dill-lk/One-Handed-Keyboard/Model/readme.md

## Heat-Set Insert and Fastener Installation Guide

#### Large Keyboard

> Left-hand large keyboard shown as the example

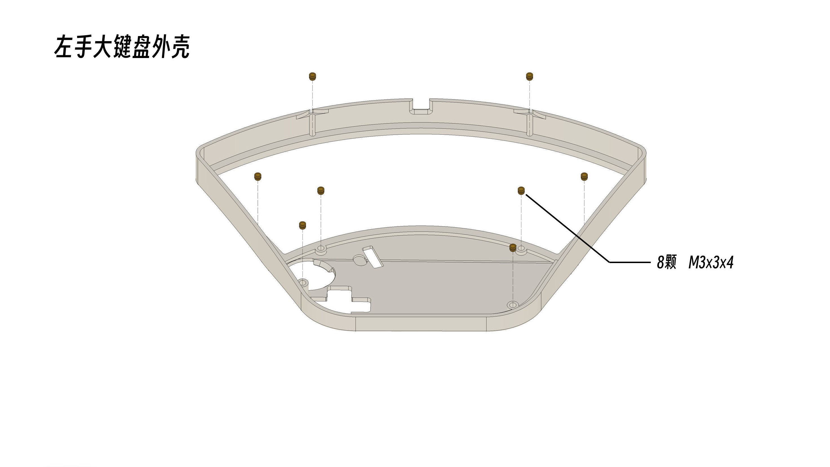
[picture p5: Docs/Image/左手大键盘外壳铜螺母安装示意图.jpg]
Large Keyboard Enclosure Heat-Set Insert Guide


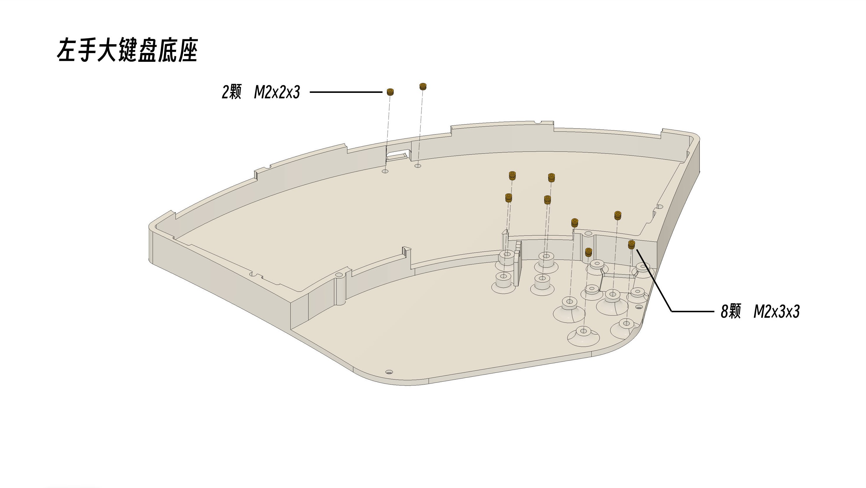
[picture p6: Docs/Image/左手大键盘底座铜螺母安装示意图.jpg]
Large Keyboard Base Heat-Set Insert Guide


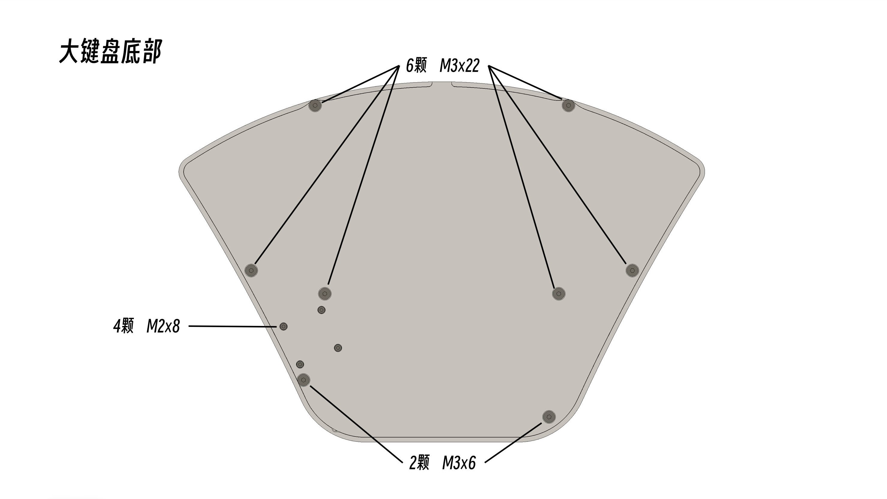
[picture p7: Docs/Image/左手大键盘底部螺丝安装示意图.jpg]
Large Keyboard Bottom Screw Installation Guide


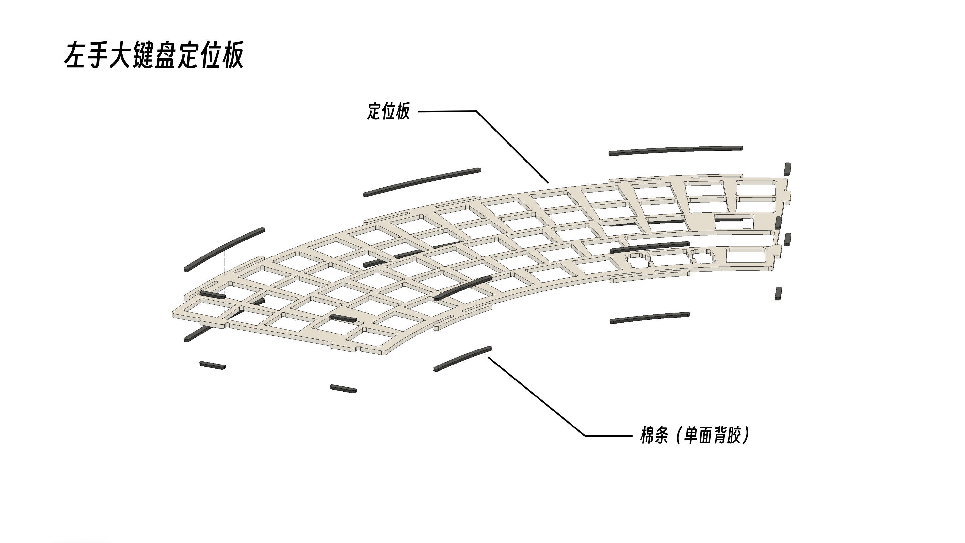
[picture p8: Docs/Image/左手大键盘棉条安装示意图.jpg]
Large Keyboard Foam Strip Installation Guide


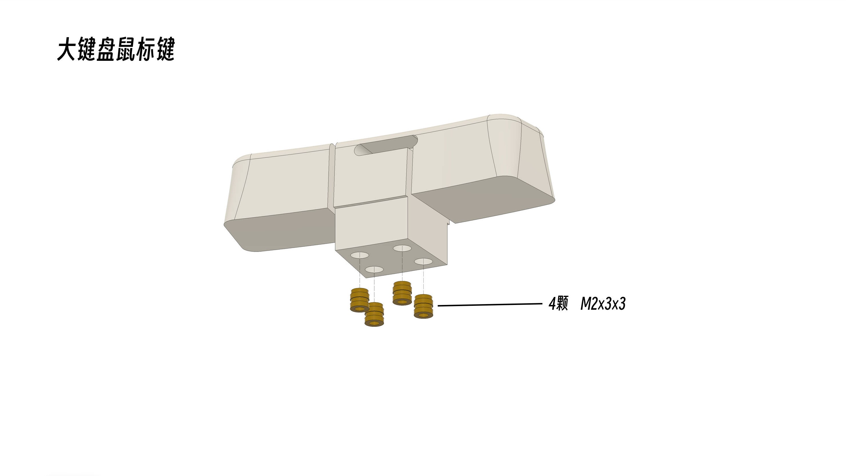
[picture p9: Docs/Image/大键盘鼠标键铜螺母安装示意图.jpg]
Large Keyboard Mouse Button Insert Guide


#### Small Keyboard

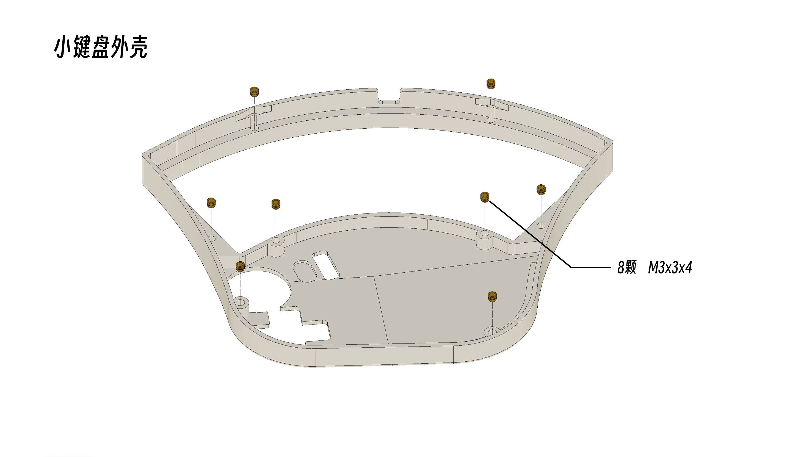
[picture p10: Docs/Image/左手小键盘外壳铜螺母安装示意图.jpg]
Small Keyboard Enclosure Heat-Set Insert Guide


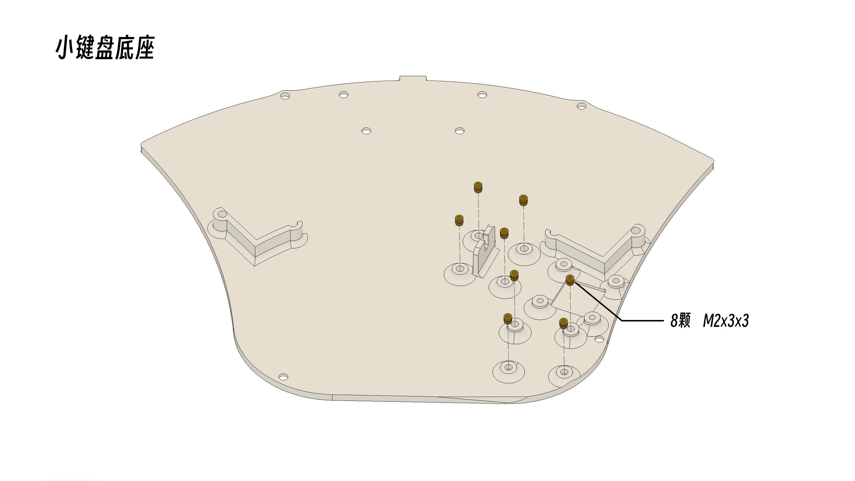
[picture p11: Docs/Image/左手小键盘底座铜螺母安装示意图.jpg]
Small Keyboard Base Heat-Set Insert Guide


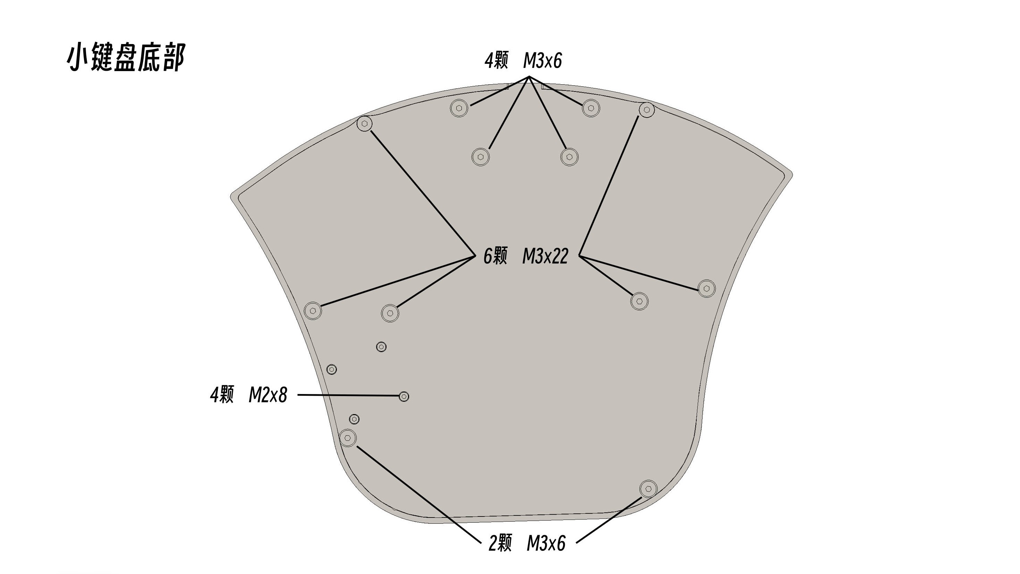
[picture p12: Docs/Image/左手小键盘底部螺丝安装示意图.jpg]
Small Keyboard Bottom Screw Installation Guide


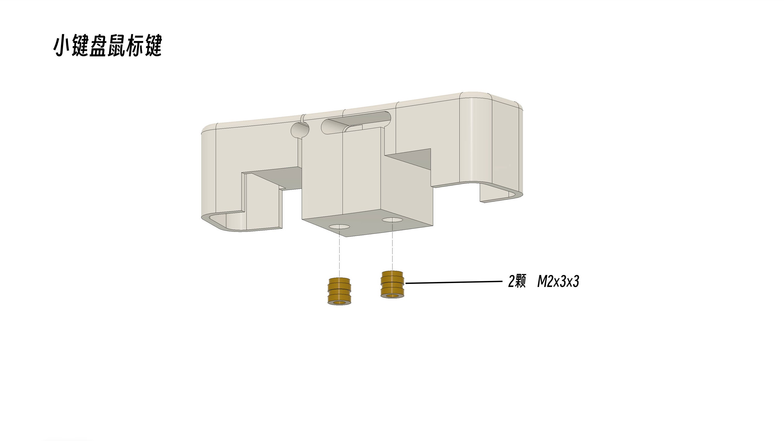
[picture p13: Docs/Image/小键盘鼠标键铜螺母安装示意图.jpg]
Small Keyboard Mouse Button Insert Guide


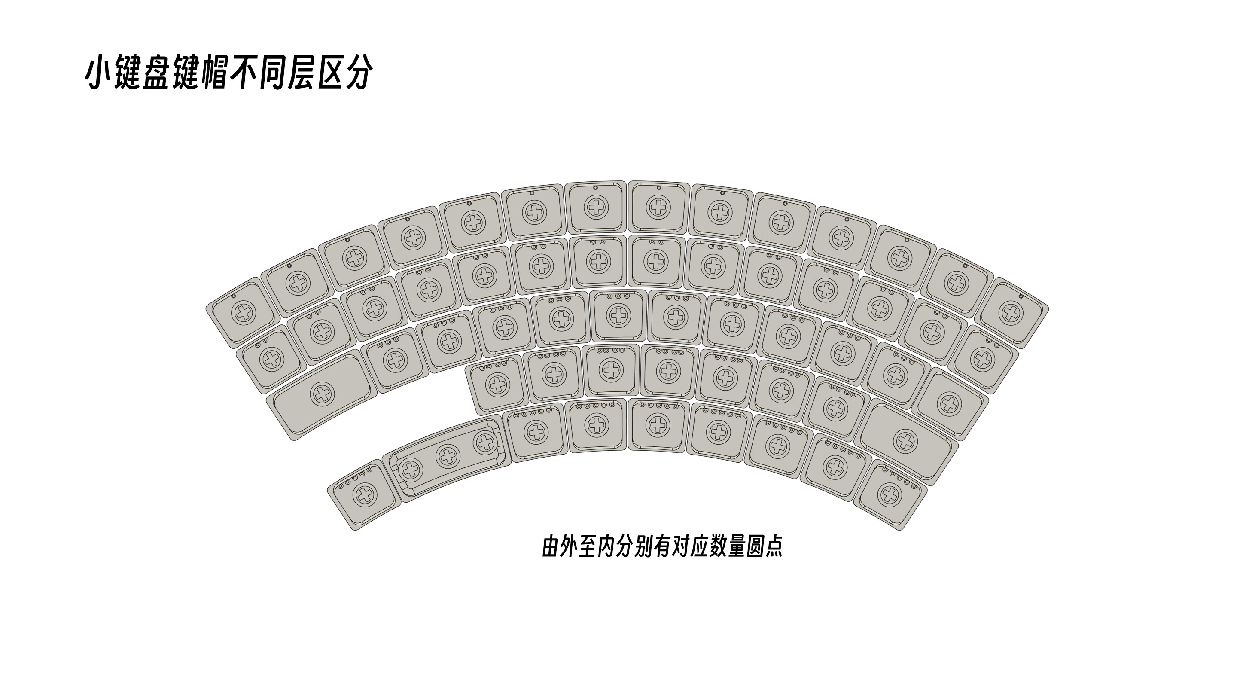
[picture p14: Docs/Image/小键盘键帽不同层区分.jpg]
Small Keyboard Keycap Layer Guide


> Keycap layer distinction is the same for both the small and large keyboards.

#### Other

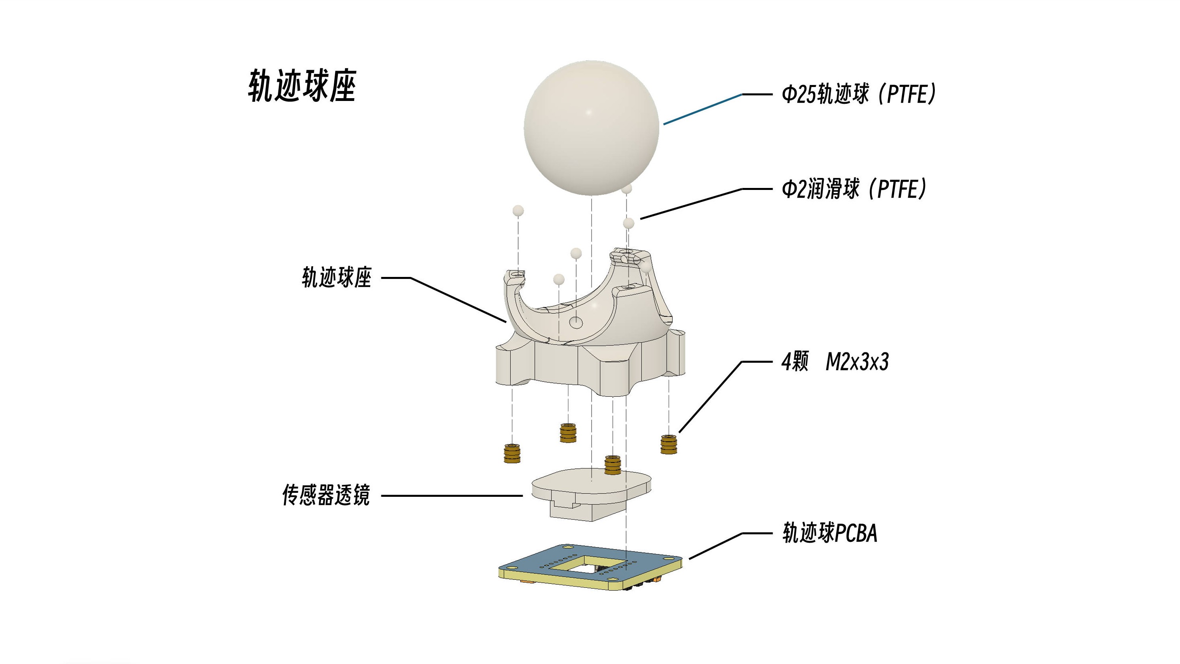
[picture p15: Docs/Image/轨迹球安装示意图.jpg]
Trackball Installation Guide
