dill-lk/One-Handed-Keyboard/Firmware/One-Handed_Keyboard_ML/readme.md

# One-Handed_Keyboard_ML

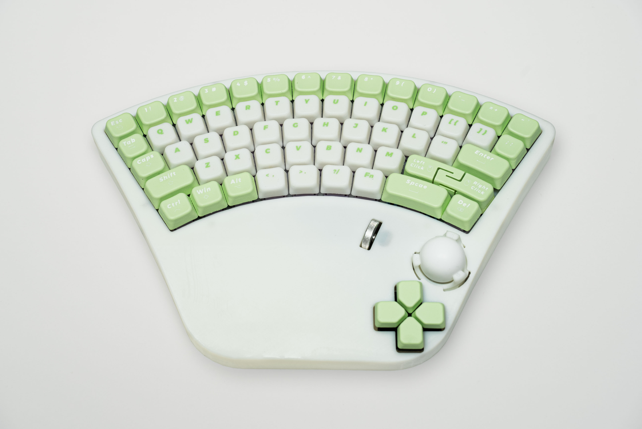
[picture p16: Docs/Image/左手大键盘正面.jpg]
Left Large Keyboard Front


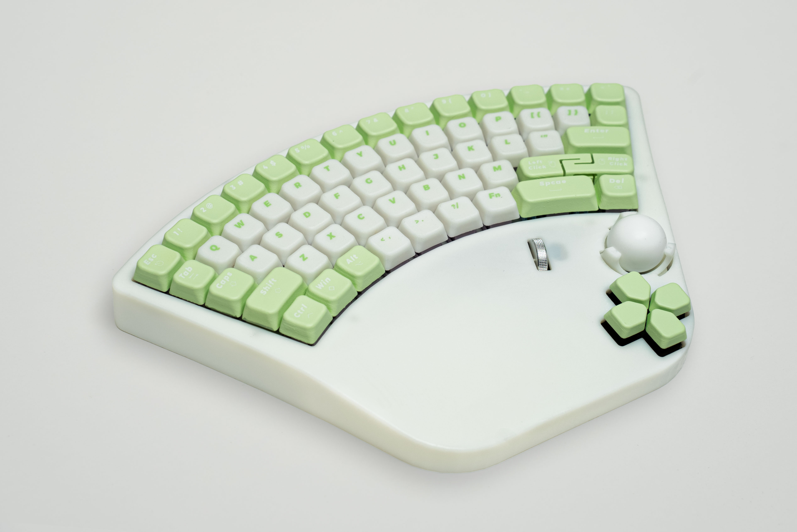
[picture p17: Docs/Image/左手大键盘左侧.jpg]
Left Large Keyboard Side


---

Powered by [QMK](https://docs.qmk.fm/)
