dill-lk/One-Handed-Keyboard/Firmware/One-Handed_Keyboard_MR/readme.md

# One-Handed_Keyboard_MR

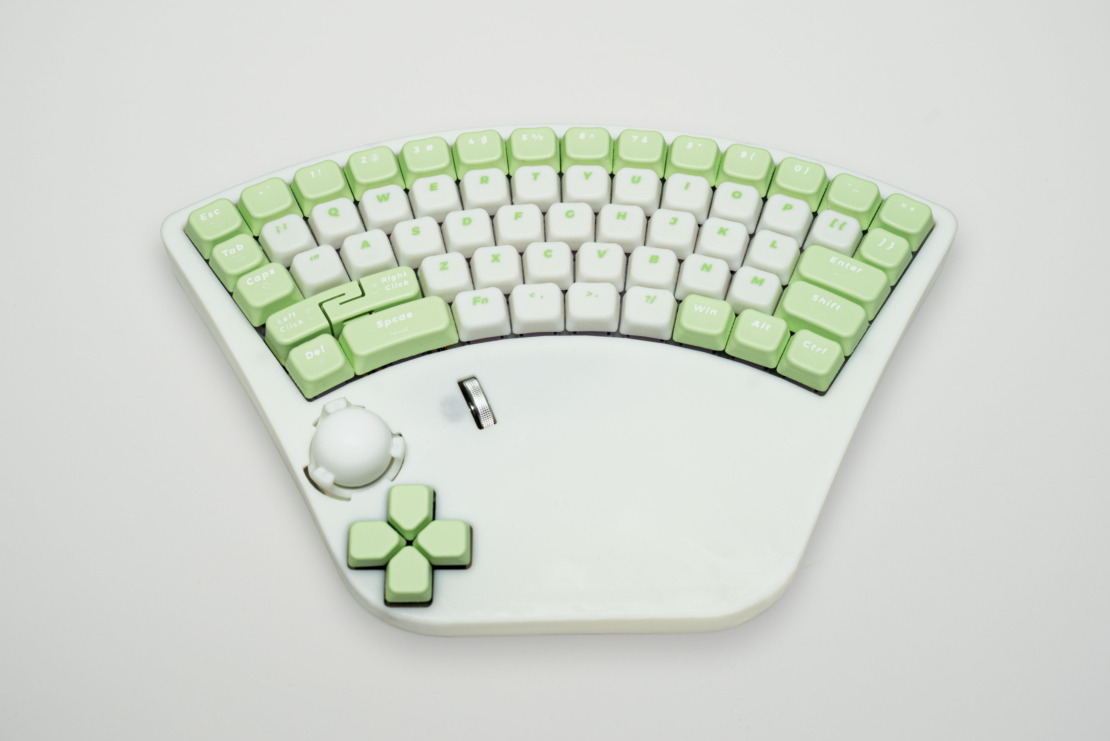
[picture p18: Docs/Image/右手大键盘正面.jpg]
Right Large Keyboard Front


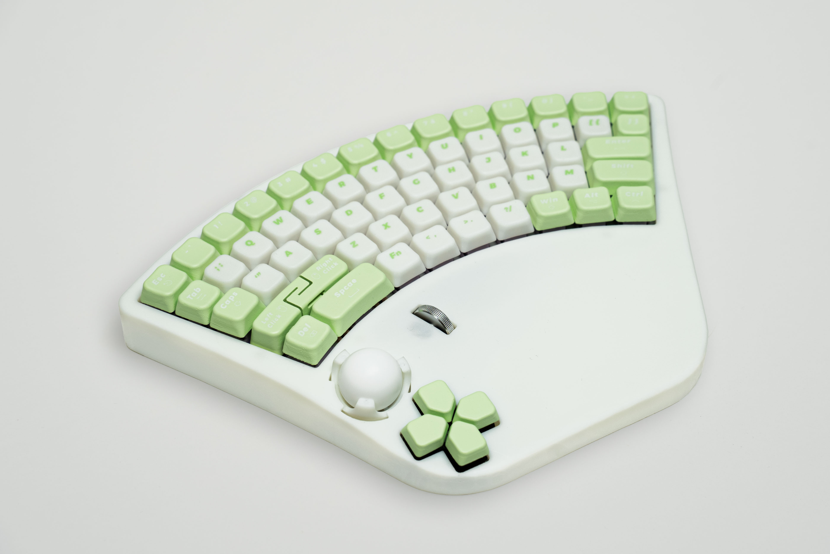
[picture p19: Docs/Image/右手大键盘左侧.jpg]
Right Large Keyboard Side


---

Powered by [QMK](https://docs.qmk.fm/)
