dill-lk/One-Handed-Keyboard/Firmware/One-Handed_Keyboard_SL/readme.md

# One-Handed_Keyboard_SL

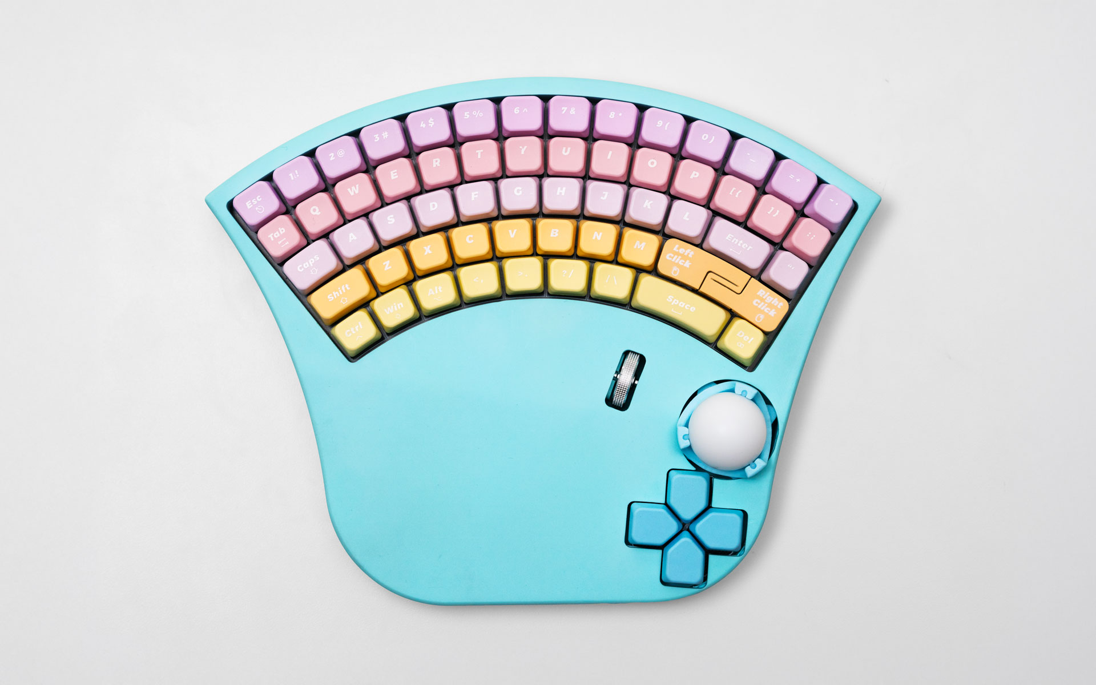
[picture p20: Docs/Image/左手小键盘正面.jpg]
Left Small Keyboard Front


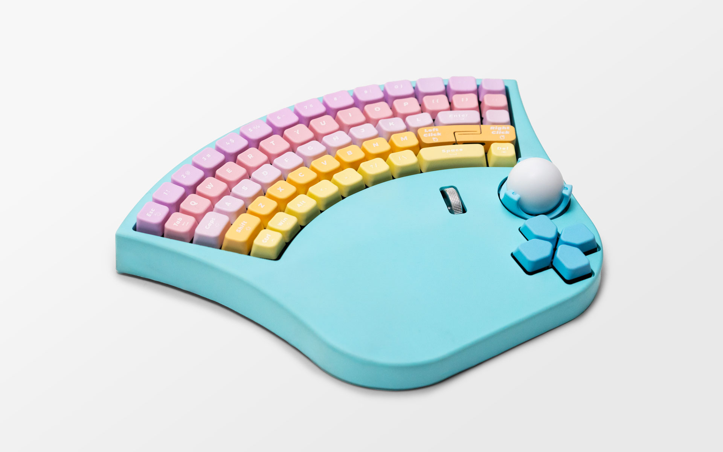
[picture p21: Docs/Image/左手小键盘左侧面.jpg]
Left Small Keyboard Side


---

Powered by [QMK](https://docs.qmk.fm/)
