dill-lk/One-Handed-Keyboard/Docs/Image/右手大键盘右侧.jpg

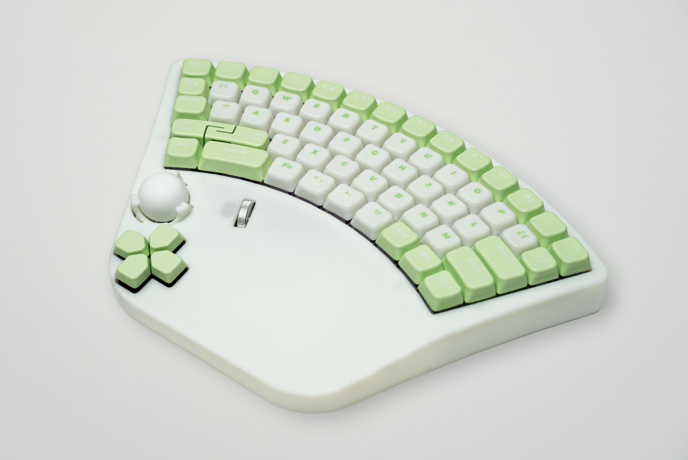
Docs/Image/右手大键盘右侧.jpg
