dill-lk/One-Handed-Keyboard/Model/One-Handed_Keyboard_ML/底座_左.STL

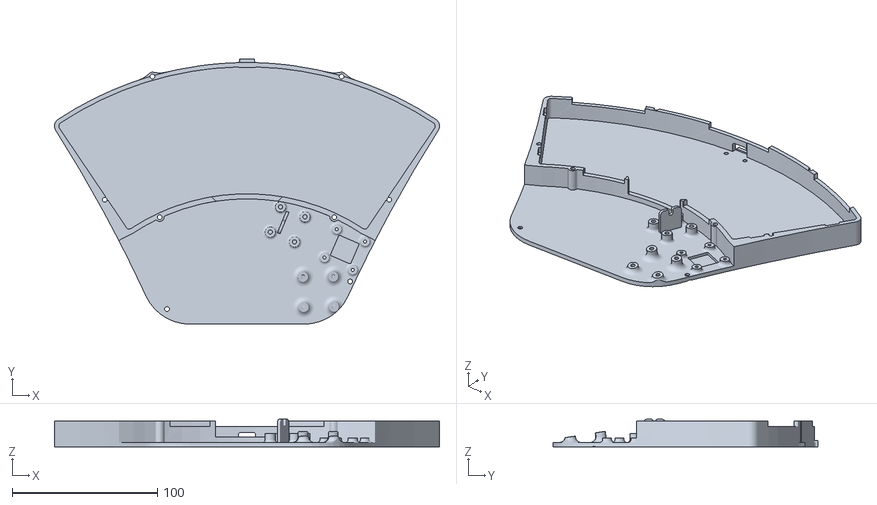
[picture p23: CAD file, 2026-04-25]
Model/One-Handed_Keyboard_ML/底座_左.STL
264.7 x 182.5 x 19.0
