dill-lk/One-Handed-Keyboard/Model/One-Handed_Keyboard_MR/定位板_右.DXF

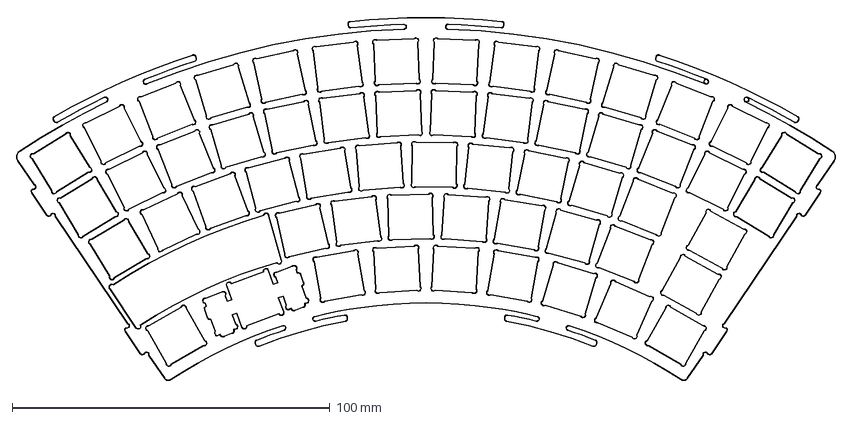
[picture p24: CAD file, 2026-04-25]
Model/One-Handed_Keyboard_MR/定位板_右.DXF
258.0 x 114.6 mm
