dill-lk/One-Handed-Keyboard/Model/One-Handed_Keyboard_SL/硅胶垫.DXF

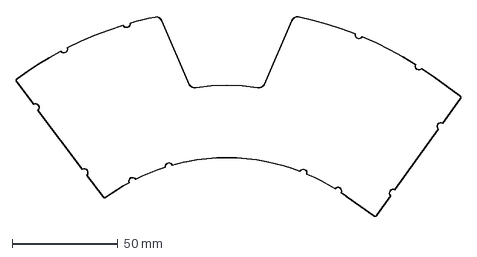
[picture p25: CAD file, 2026-04-25]
Model/One-Handed_Keyboard_SL/硅胶垫.DXF
210.0 x 94.5 mm
