dill-lk/One-Handed-Keyboard/Model/One-Handed_Keyboard_ML/外壳_左.STL

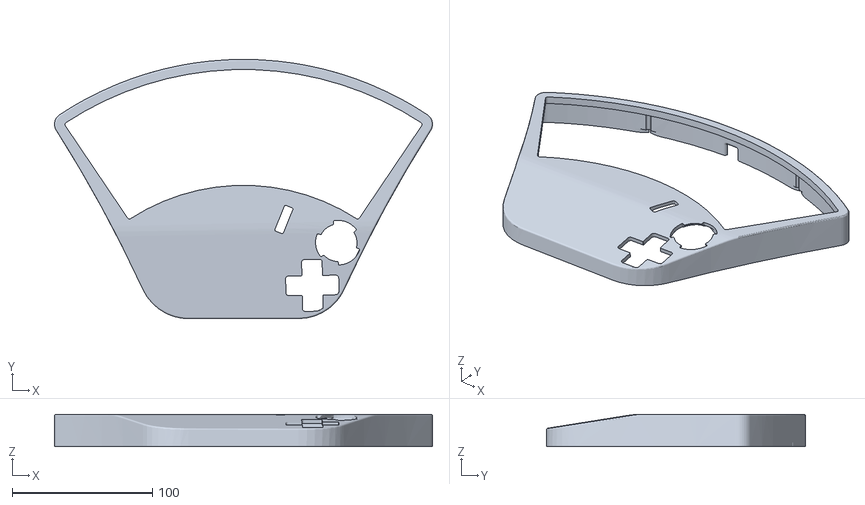
[picture p26: CAD file, 2026-04-25]
Model/One-Handed_Keyboard_ML/外壳_左.STL
269.8 x 185.0 x 23.0
