dill-lk/One-Handed-Keyboard/Model/One-Handed_Keyboard_MR/左右键.STL

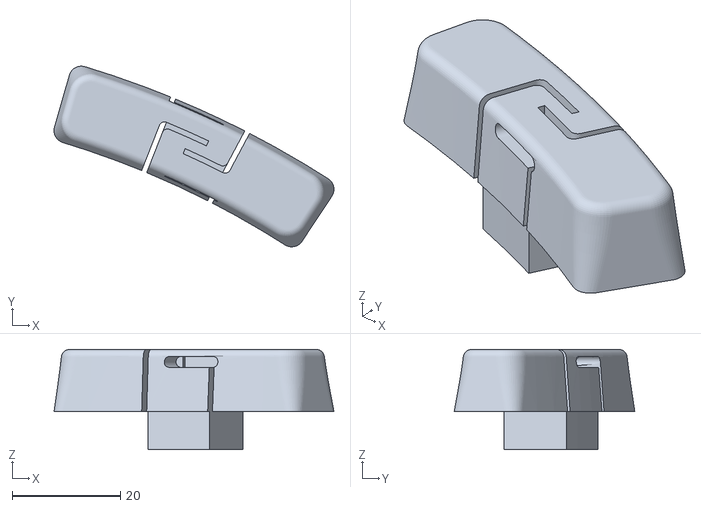
[picture p27: CAD file, 2026-04-25]
Model/One-Handed_Keyboard_MR/左右键.STL
51.8 x 33.4 x 18.5
