dill-lk/One-Handed-Keyboard/Model/One-Handed_Keyboard_SL/外壳.STL

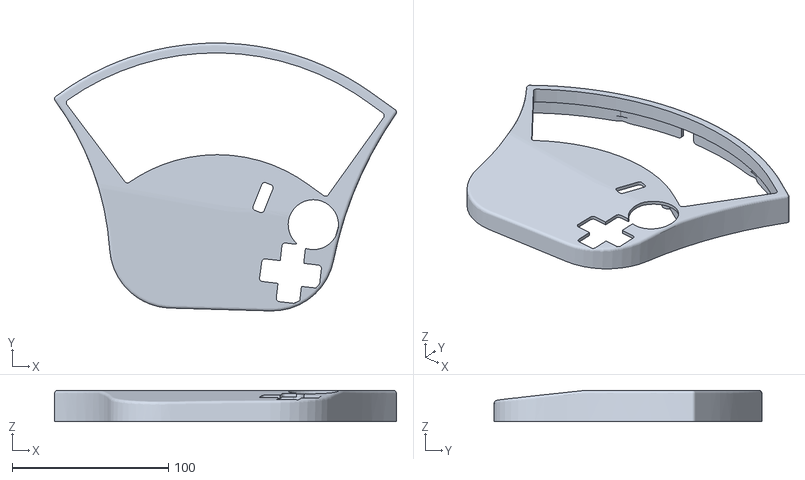
[picture p28: CAD file, 2026-04-25]
Model/One-Handed_Keyboard_SL/外壳.STL
218.6 x 171.2 x 20.0
