dill-lk/One-Handed-Keyboard/Model/One-Handed_Keyboard_ML/轨迹球座.STL

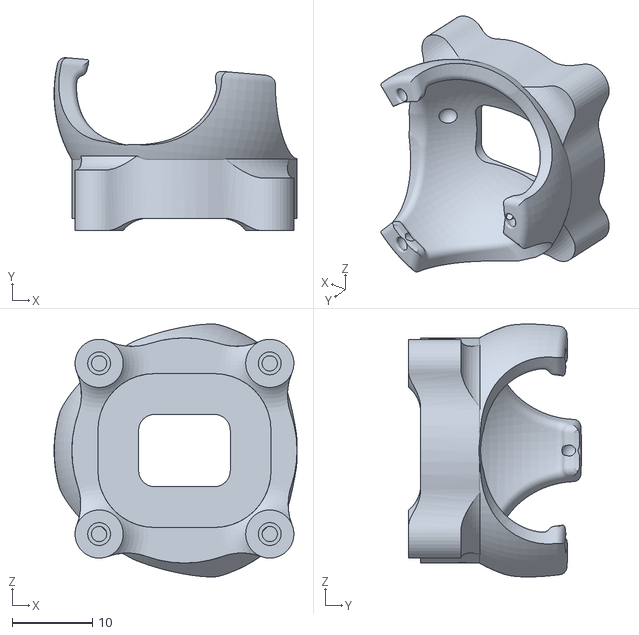
[picture p29: CAD file, 2026-04-25]
Model/One-Handed_Keyboard_ML/轨迹球座.STL
30.2 x 21.5 x 31.5
