dill-lk/One-Handed-Keyboard/Model/One-Handed_Keyboard_MR/方向键键帽.STL

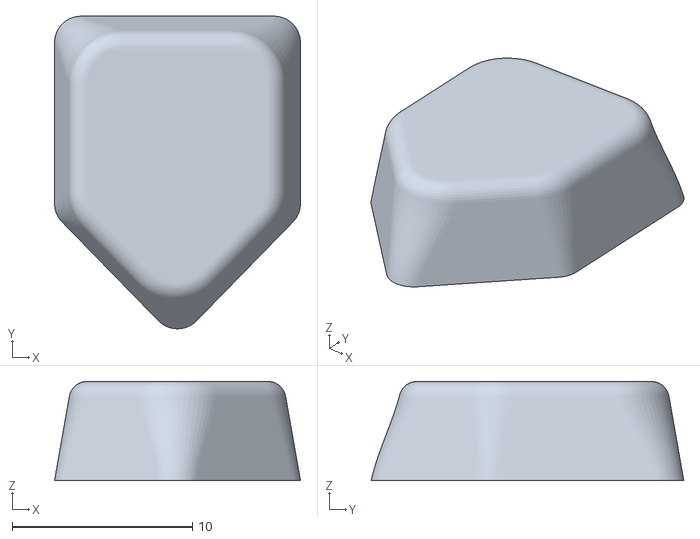
[picture p30: CAD file, 2026-04-25]
Model/One-Handed_Keyboard_MR/方向键键帽.STL
13.6 x 17.3 x 5.50
