dill-lk/One-Handed-Keyboard/Model/One-Handed_Keyboard_SL/底座.STL

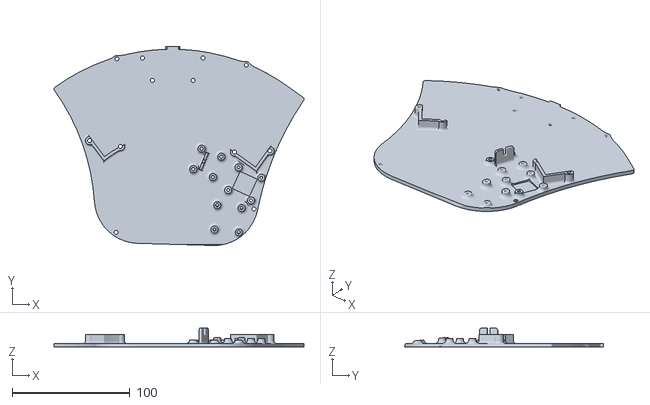
[picture p31: CAD file, 2026-04-25]
Model/One-Handed_Keyboard_SL/底座.STL
212.2 x 168.9 x 16.0
