dill-lk/One-Handed-Keyboard/Model/One-Handed_Keyboard_ML/轴座棉_左.DXF

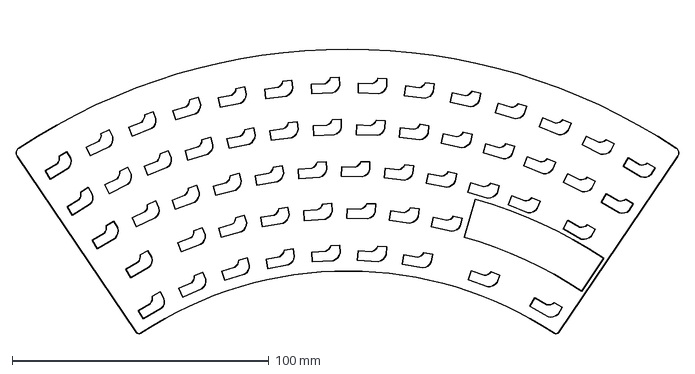
[picture p32: CAD file, 2026-04-25]
Model/One-Handed_Keyboard_ML/轴座棉_左.DXF
258.0 x 123.6 mm
