dill-lk/One-Handed-Keyboard/Model/One-Handed_Keyboard_MR/底棉.DXF

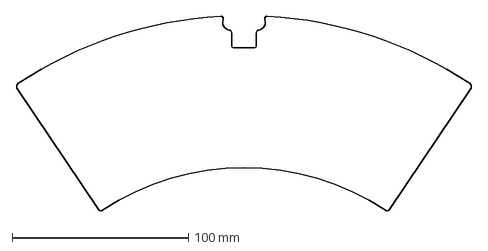
[picture p33: CAD file, 2026-04-25]
Model/One-Handed_Keyboard_MR/底棉.DXF
258.0 x 110.4 mm
