dill-lk/One-Handed-Keyboard/Model/One-Handed_Keyboard_MR/外壳_右.STL

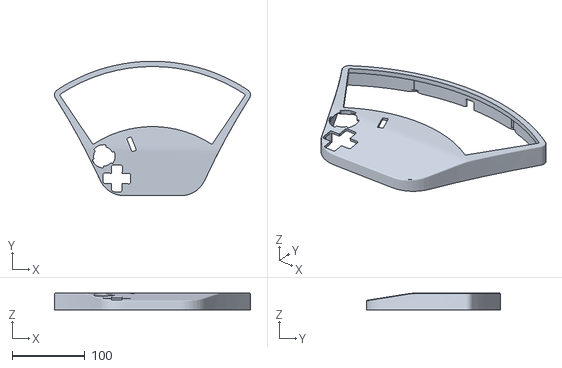
[picture p34: CAD file, 2026-04-25]
Model/One-Handed_Keyboard_MR/外壳_右.STL
269.8 x 185.0 x 23.0
