dill-lk/One-Handed-Keyboard/Model/One-Handed_Keyboard_ML/定位板上下棉条.DXF

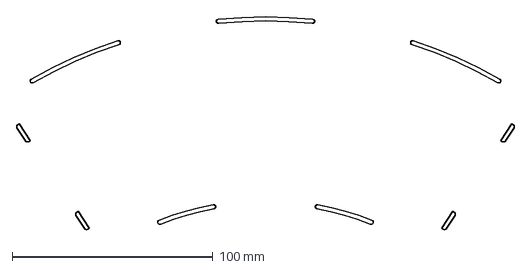
[picture p35: CAD file, 2026-04-25]
Model/One-Handed_Keyboard_ML/定位板上下棉条.DXF
248.6 x 106.5 mm
