dill-lk/One-Handed-Keyboard/Model/One-Handed_Keyboard_SL/左右键.STL

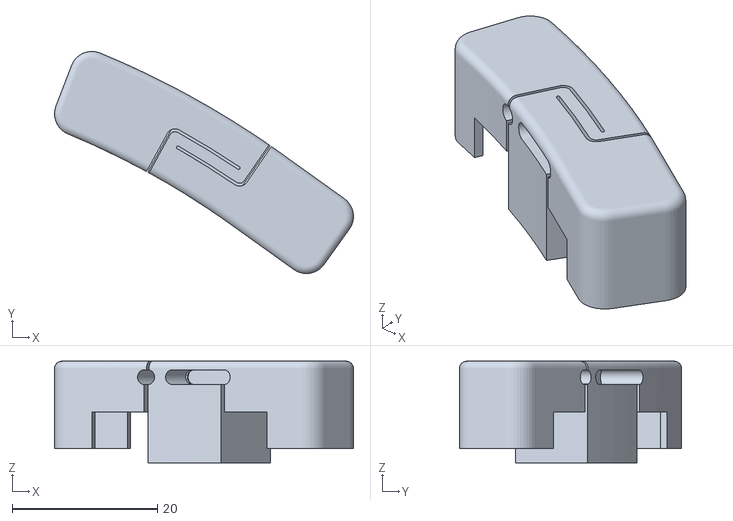
[picture p36: CAD file, 2026-04-25]
Model/One-Handed_Keyboard_SL/左右键.STL
41.2 x 30.6 x 14.0
