dill-lk/One-Handed-Keyboard/Model/One-Handed_Keyboard_ML/夹心棉_左.DXF

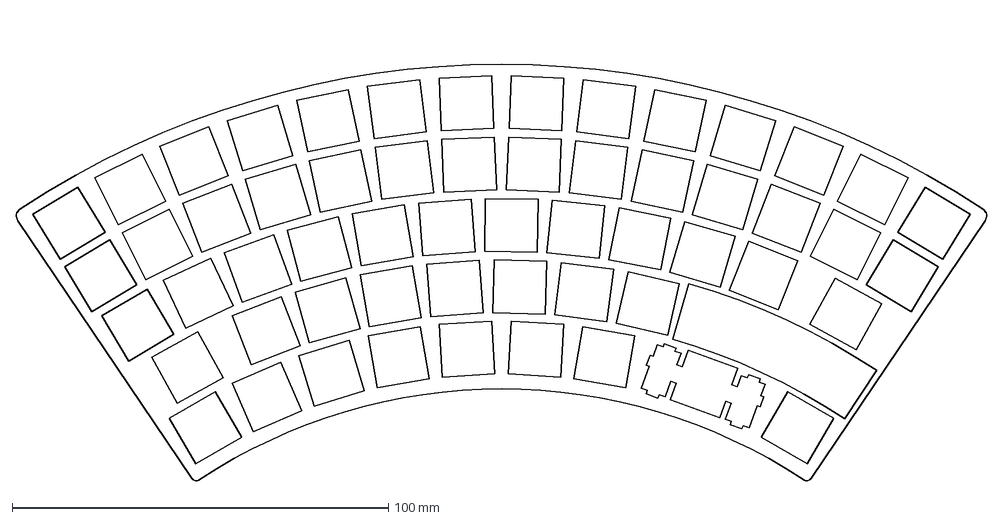
[picture p37: CAD file, 2026-04-25]
Model/One-Handed_Keyboard_ML/夹心棉_左.DXF
258.0 x 123.6 mm
