dill-lk/One-Handed-Keyboard/Model/One-Handed_Keyboard_ML/定位板_左.DXF

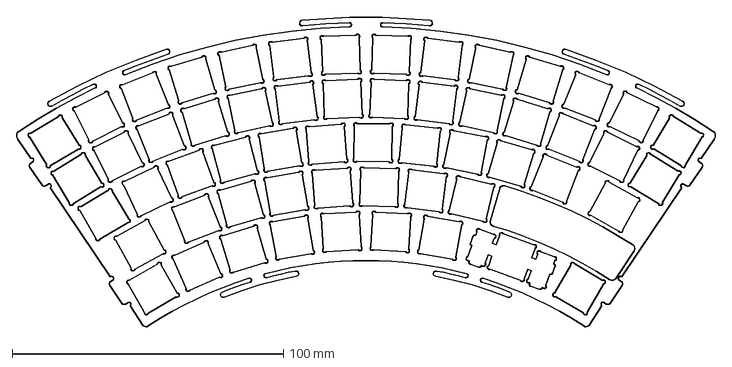
[picture p38: CAD file, 2026-04-25]
Model/One-Handed_Keyboard_ML/定位板_左.DXF
258.0 x 114.6 mm
