dill-lk/One-Handed-Keyboard/Model/One-Handed_Keyboard_MR/轴座棉_右.DXF

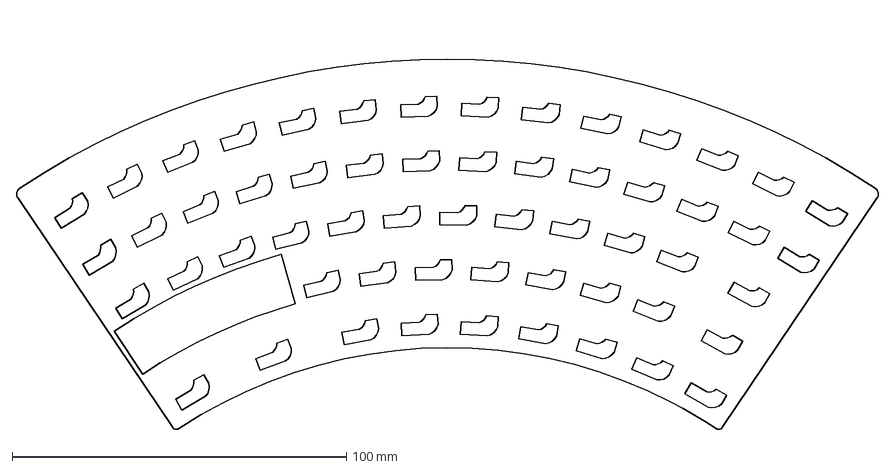
[picture p40: CAD file, 2026-04-25]
Model/One-Handed_Keyboard_MR/轴座棉_右.DXF
258.0 x 123.6 mm
