dill-lk/One-Handed-Keyboard/(list of files, cad)

Other CAD files:
Model/One-Handed_Keyboard_MR/底座_右.STL
