dill-lk/One-Handed-Keyboard/(list of files, drawings)

Other design files:
Hardware/ProPrj_HTXStudio_OneHanded_Keyboard.epro
